JChristensen/serialLogger/schematic.png

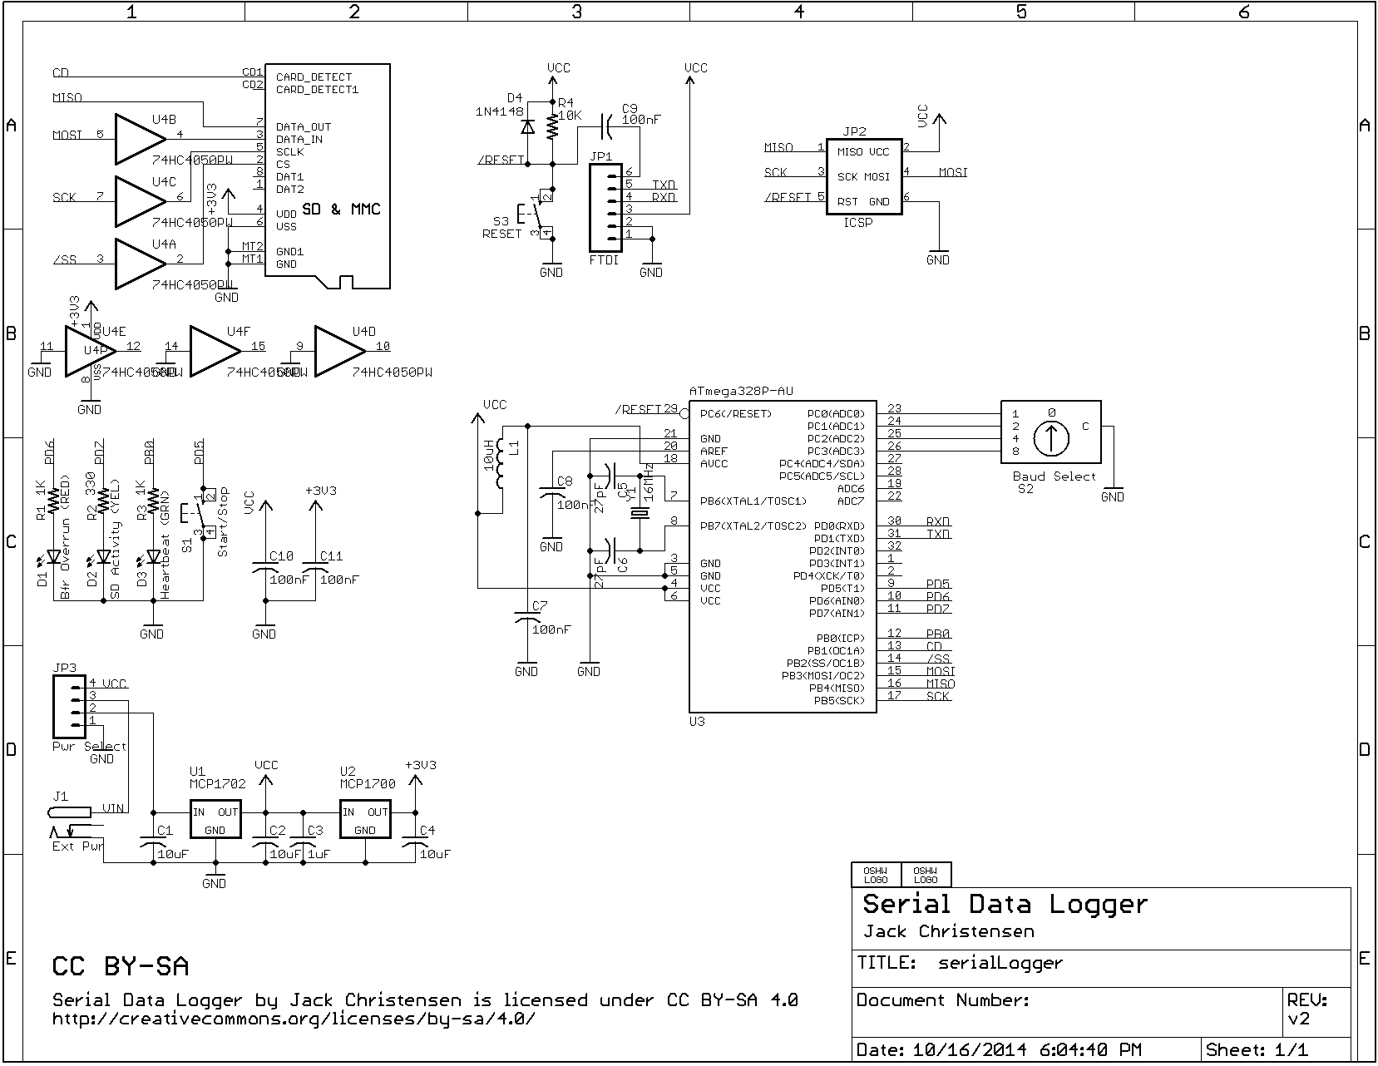
schematic.png
