JChristensen/serialLogger/buffer.h

// Serial Data Logger
// https://github.com/JChristensen/serialLogger
// Copyright (C) 2018 by Jack Christensen and licensed under
// GNU GPL v3.0, https://www.gnu.org/licenses/gpl.html

#include <util/atomic.h>

const int NBUF(2);                      // number of receive buffers
const uint16_t BUFSIZE(512);            // serial receive buffer size

/*-------- buffer class --------*/
class buffer
{
    public:
        buffer() {}
        void init(int8_t writeLED = -1);
        int putch(uint8_t ch);
        int write(SdFile* f);
        int flush(SdFile* f);

        volatile uint8_t buf[BUFSIZE];  // the buffer
        volatile uint8_t* next;         // pointer to next available position in buffer
        volatile uint16_t nchar;        // number of characters in the buffer
        volatile bool writeMe;          // buffer is full and needs to be written

    private:
        static int8_t m_writeLED;
        static uint8_t m_ledMask;
        static volatile uint8_t* m_ledReg;
};

int8_t buffer::m_writeLED;
uint8_t buffer::m_ledMask;
volatile uint8_t* buffer::m_ledReg;

// initialize the buffer
void buffer::init(int8_t writeLED)
{
    nchar = 0;                          // buffer is empty
    next = buf;                         // point at the first byte
    writeMe = false;                    // does not need to be written

    m_writeLED = writeLED;
    if (m_writeLED >= 0)
    {
        pinMode(m_writeLED, OUTPUT);
        m_ledMask = digitalPinToBitMask(m_writeLED);    // save some cycles by addressing port directly
        uint8_t port = digitalPinToPort(m_writeLED);
        m_ledReg = portOutputRegister(port);
        *m_ledReg &= ~m_ledMask;
    }
}

// put a character into the buffer (Context: ISR)
// returns -1 if the character filled the buffer,
// else returns the character.
int buffer::putch(uint8_t ch)
{
    *next++ = ch;               // put the character in the next available location
    if ( ++nchar >= BUFSIZE )
    {
        writeMe = true;
        return -1;
    }
    else
    {
        return ch;
    }
}

// write the buffer if it's full (i.e. if writeMe is set).
// passes the return code from SdFile.write() back to the caller (-1 for error, else number of bytes written).
// if the sync fails, return code -2 is given.
int buffer::write(SdFile* f)
{
    int sdStat = 0;

    if ( writeMe )
    {
        writeMe = false;
        *m_ledReg |= m_ledMask;
        sdStat = f -> write((const uint8_t *)buf, nchar);   // write the buffer to SD
        if ( !(f -> sync()) ) sdStat = -2;
        *m_ledReg &= ~m_ledMask;
        if (sdStat >= 0) nchar = 0;                 // the buffer is empty/available again
    }
    return sdStat;
}

// write the buffer if it contains data.
// passes the return code from SdFile.write() back to the caller (-1 for error, else number of bytes written).
// if the sync fails, return code -2 is given.
int buffer::flush(SdFile* f)
{
    int sdStat = 0;

    if ( nchar > 0 )
    {
        writeMe = false;
        *m_ledReg |= m_ledMask;
        sdStat = f -> write((const uint8_t *)buf, nchar);   // write the buffer to SD
        if ( !(f -> sync()) ) sdStat = -2;
        *m_ledReg &= ~m_ledMask;
        if (sdStat >= 0) nchar = 0;             // the buffer is empty/available again
    }
    return sdStat;
}

/*-------- bufferPool class --------*/
class bufferPool
{
    public:
        bufferPool(int8_t writeLED = -1) : m_writeLED(writeLED) {}
        void init();
        int putch(uint8_t ch);
        int write(SdFile* f);
        int flush(SdFile* f);

        buffer buf[NBUF];
        volatile bool overrun;

    private:
        buffer* m_curBuf;               // pointer to current buffer
        volatile uint8_t m_bufIdx;      // index to the current buffer
        buffer* m_writeBuf;             // pointer to buffer to write
        uint8_t m_writeIdx;             // index to the buffer to write
        int8_t m_writeLED;
        uint16_t m_lost;
};

void bufferPool::init()
{
    for (uint8_t i = 0; i < NBUF; i++)  // initialize the buffers
    {
        buf[i].init(m_writeLED);
    }
    m_bufIdx = 0;
    m_writeIdx = 0;
    m_curBuf = &buf[m_bufIdx];
    m_lost = 0;
    overrun = false;
}

// put a character into a buffer (Context: ISR)
// if the character filled the buffer, but if the next buffer was not
// yet written and cleared by the mainline code, returns -1,
// else returns the character.
int bufferPool::putch(uint8_t ch)
{
    uint8_t ret = ch;

    if ( !overrun )                                 // is there room for the character?
    {
        if ( m_curBuf -> putch(ch) < 0 )            // yes, did the character fill the buffer?
        {
            if ( ++m_bufIdx >= NBUF ) m_bufIdx = 0; // yes, switch buffers
            m_curBuf = &buf[m_bufIdx];              // point to the next buffer
            m_curBuf -> next = m_curBuf -> buf;     // the next character goes in the first location
            if ( m_curBuf -> nchar != 0 )           // if mainline code has not zeroed the character count,
            {
                overrun = true;                     // then we have an overrun situation
                ret = -1;
            }
        }
    }
    else if ( m_curBuf -> nchar == 0 )              // has previous overrun cleared?
    {
        overrun = false;
        m_curBuf -> putch('<');                     // insert a message
        m_curBuf -> putch('L');
        m_curBuf -> putch('O');
        m_curBuf -> putch('S');
        m_curBuf -> putch('T');
        m_curBuf -> putch(' ');
        m_curBuf -> putch('0');
        m_curBuf -> putch('x');
        for (uint8_t i = 0; i < 4; i++)             // convert count of lost chars to hex
        {
            uint16_t n = ( m_lost & 0xF000 ) >> 12;
            n = n + ( (n > 9) ? 'A' - 10 : '0' );
            m_curBuf -> putch(n);
            m_lost <<= 4;
        }
        m_curBuf -> putch('>');
        m_curBuf -> putch(ch);                      // yes, put the character into the buffer
        m_lost = 0;
    }
    else
    {
        ++m_lost;                                   // no, this character was lost
        ret = -1;                                   // still have overrun situation
    }
    return ret;
}

// write a buffer if it's full.
// moves to the next buffer on each call.
// passes the return code from SdFile.write() back to the caller.
int bufferPool::write(SdFile* f)
{
    int sdStat = 0;
    m_writeBuf = &buf[m_writeIdx];                  // point to the buffer
    sdStat = m_writeBuf -> write(f);                // write the buffer to SD
    if ( ++m_writeIdx >= NBUF ) m_writeIdx = 0;     // increment index to next buffer
    return sdStat;
}

// starting with the oldest buffer, write any that contain data.
// passes the return code from SdFile.write() back to the caller.
int bufferPool::flush(SdFile* f)
{
    int sdStat = 0;
    ATOMIC_BLOCK(ATOMIC_RESTORESTATE)
    {
        m_writeIdx = ++m_bufIdx;                    // index to oldest buffer
    }
    if ( m_writeIdx >= NBUF ) m_writeIdx = 0;

    for (uint8_t i = 0; i < NBUF; i++ )
    {
        m_writeBuf = &buf[m_writeIdx];              // point to the buffer
        sdStat = m_writeBuf -> flush(f);            // write the buffer to SD
        if (sdStat < 0) break;
        if ( ++m_writeIdx >= NBUF ) m_writeIdx = 0; // increment index to next buffer
    }
    return sdStat;
}

// poor man's Serial.println() substitute
void writeUSART0(char* buf)
{
    char c;

    uint8_t ucsr0b = UCSR0B;

    while ( (c = *buf++) != 0 )
    {
        loop_until_bit_is_set(UCSR0A, UDRE0);
        UDR0 = c;
    }
    loop_until_bit_is_set(UCSR0A, UDRE0);
    UDR0 = '\r';
    loop_until_bit_is_set(UCSR0A, UDRE0);
    UDR0 = '\n';
    UCSR0B = ucsr0b;
}
