JChristensen/serialLogger/(commit log)

2014-07-03 Add schematic.
2014-07-03 Invert card detect logic.
    [serialLogger.ino]
2014-07-06 Handle SD LED in buffer class, use direct port manipulation.
2014-07-06 Increase buffers to 512 bytes. Direct port manipulation for heartbeat LED. Change to SPI_FULL_SPEED. Drop 300 baud.
2014-07-22 Close log file on SD error. Rename private variables.
    [buffer.h, serialLogger.ino]
2014-11-05 v2 firmware to support custom PC board.
2014-11-06 Reset MCU when SD card inserted. Minor changes to card detect switch handling.
    [buffer.h, serialLogger.ino]
2014-11-07 Add LED test in setup().
2014-11-11 Doc update, update PCB picture.
2018-05-22 Changes for latest version of the Button library (JC_Button.h).
2018-05-23 Add ((used)) attribute to wdt_init function. (Was not required in earlier release but Arduino 1.8.5 seems to need it.) Rename the main state machine states.
2018-05-23 Remove hardware (pin) initialization from buffer constructor. Change bufferPool constructor to use member initialization. Change license to GPL. Update README file.
